ttrang126/Project_I/(list of files, cad)

Other CAD files:
SOFTWARE/CODE/Code/main.OBJ
SOFTWARE/Code_HS/main.OBJ
SOFTWARE/CODE/Code/delay.OBJ
SOFTWARE/CODE/Objects/STARTUP.obj
SOFTWARE/Code_ADC/CODE/Objects/LCD_new.obj
SOFTWARE/Code_HS/hs1101.OBJ
SOFTWARE/Test_Code/STARTUP.OBJ
SOFTWARE/CODE/Code/STARTUP.OBJ
SOFTWARE/CODE/Objects/tt.obj
SOFTWARE/Code_ADC/CODE/Objects/tesst.obj
SOFTWARE/Code_HS/STARTUP.OBJ
SOFTWARE/CODE/Objects/LCD.obj
SOFTWARE/Code_ADC/CODE/Objects/lcdlcd.obj
SOFTWARE/Code_HS/delay.OBJ
SOFTWARE/CODE/Code/lcd1602.OBJ
SOFTWARE/CODE/Objects/LCD_new.obj
SOFTWARE/Code_ADC/CODE/Objects/tt.obj
SOFTWARE/Code_HS/adc0804.OBJ
SOFTWARE/CODE/Code/hs1101.OBJ
SOFTWARE/CODE/Objects/lcdlcd.obj
SOFTWARE/Code_ADC/CODE/Objects/LCD.obj
SOFTWARE/Code_HS/lcd1602.OBJ
SOFTWARE/CODE/Objects/tesst.obj
SOFTWARE/Code_ADC/CODE/Objects/STARTUP.obj
