ttrang126/Project_I/(list of files, drawings)

Other design files:
HARDWARE/DA1.PcbDoc
HARDWARE/DA1_ver2.PcbDoc
HARDWARE/LOGO.pcbdoc
HARDWARE/Schematic.SchDoc
HARDWARE/Schematic_new.schdoc
HARDWARE/ĐỒ ÁN 1_Project.PrjPcb
SOFTWARE/Simulation/Project Backups/Simulation [20230628, 09-42-38].pdsprj
SOFTWARE/Simulation/Project Backups/Simulation [20230628, 20-07-29].pdsprj
SOFTWARE/Simulation/Project Backups/Simulation [20230703, 09-38-06].pdsprj
SOFTWARE/Simulation/Project Backups/Simulation [20230703, 22-11-00].pdsprj
SOFTWARE/Simulation/Project Backups/Simulation [20230704, 13-20-17].pdsprj
SOFTWARE/Simulation/Project Backups/Simulation [20230705, 11-40-30].pdsprj
SOFTWARE/Simulation/Project Backups/Simulation [20230705, 14-28-48].pdsprj
SOFTWARE/Simulation/Project Backups/Simulation [20230715, 22-34-38].pdsprj
SOFTWARE/Simulation/Project Backups/Simulation [20230718, 23-57-15].pdsprj
SOFTWARE/Simulation/Project Backups/Simulation [20230812, 11-35-55].pdsprj
SOFTWARE/Simulation/Simulation.pdsprj
